Eddym06/MiguelOHM/Diseño Caja 3D/README.md

# Diseño Caja 3D

Carpeta para los diseños 3D de la caja.
