Eddym06/MiguelOHM/Diseño de carrito/README.md

# Diseño de carrito

Carpeta para los diseños del carrito.
