Eddym06/MiguelOHM/Codigo Carrito/README.md

# Código Carrito

Carpeta para el código del carrito.
