Eddym06/MiguelOHM/Documentación/DOC - CARRITO DOCUMENTO.docx

Especificación de requisitos de software

Proyecto: Sistema Carrito RC

Revisión 3

| | Octubre de 2026

De la plantilla de formato del documento © & Coloriuris http://www.qualitatis.org

# Ficha del documento

Fecha | Revisión | Autor | Verificado dep. calidad.
2026-10-09 | 1 | Simone Bariola
2026-10-23 | 2 | Simone Bariola
2026-10-29 | 3 | Simone Bariola

Documento validado por las partes en fecha:

Por el cliente | Por la empresa suministradora
Fdo. D./ Dña | Fdo. D./Dña

# Contenido

# 1 Introducción

## 1.1 Propósito

Este documento especifica los requisitos del Sistema Carrito RC, proyecto final de la asignatura Microcontroladores del Instituto Tecnológico de las Américas (ITLA), cuatrimestre 2026-C-3. Su objetivo es definir de forma verificable las funciones, las interfaces y las restricciones del sistema, y servir de base para el diseño mecánico, el diseño de la PCB, la programación del microcontrolador y las pruebas de aceptación.

Está dirigido al profesor de la asignatura, Carlos Antonio Pichardo, como cliente y evaluador del proyecto, y a los integrantes del equipo de desarrollo.

## 1.2 Alcance

El producto a desarrollar se denomina Sistema Carrito RC y comprende el Carrito y el Control giroscópico [TBR: inclusión del Control giroscópico en el producto]. El sistema permite conducir el Carrito de forma manual, desde el Control giroscópico o desde un dispositivo Bluetooth, y hacerlo navegar de forma autónoma entre coordenadas predefinidas mediante GPS, detectando los obstáculos y desviándose de ellos. Además, mantiene la velocidad de crucero en pendientes, informa al usuario del rumbo y del nivel de batería, e indica la velocidad mediante una tira LED.

No existe un documento de mayor nivel: esta SRS es la especificación de referencia del proyecto. [TBD: elementos fuera del alcance].

## 1.3 Personal involucrado

Nombre | Carlos Antonio Pichardo
Rol | Cliente y evaluador del proyecto (profesor de la asignatura Microcontroladores)
Categoría profesional
Responsabilidades
Información de contacto | cpichardo@itla.edu.do
Aprobación

Nombre | Simone Bariola
Rol
Categoría profesional
Responsabilidades | Documentación y diseño del Carrito
Información de contacto
Aprobación

Nombre | Eddy Manuel Piantini [TBR: nombre completo]
Rol
Categoría profesional
Responsabilidades
Información de contacto
Aprobación

Nombre | Edwin Joel Cabrera de Los Santos
Rol
Categoría profesional
Responsabilidades
Información de contacto
Aprobación

Nombre | José Nicolas Sánchez Zorrilla
Rol
Categoría profesional
Responsabilidades
Información de contacto
Aprobación

Nombre | Yisbel Diaz Brito
Rol
Categoría profesional
Responsabilidades
Información de contacto
Aprobación

Nombre | Josue Herrera
Rol
Categoría profesional
Responsabilidades
Información de contacto
Aprobación

## 1.4 Definiciones, acrónimos y abreviaturas

SRS: Especificación de requisitos de software (Software Requirements Specification).

RF: Requisito funcional. RNF: Requisito no funcional.

TBD: Por definir (To Be Defined). TBR: Por revisar (To Be Reviewed).

CAD: Diseño asistido por computadora.

PCB: Placa de circuito impreso.

GPS: Sistema de posicionamiento global.

LED: Diodo emisor de luz.

Modo giroscopio: conducción del Carrito mediante la inclinación del Control giroscópico.

Velocidad de crucero: velocidad de desplazamiento constante que el Carrito mantiene sin intervención del usuario.

Rumbo: orientación del Carrito respecto al norte, expresada en grados.

En este documento, la abreviatura RF designa siempre un requisito funcional; el término radiofrecuencia se escribe completo.

## 1.5 Referencias

Referencia | Titulo | Ruta | Fecha | Autor
[1] | IEEE Recommended Practice for Software Requirements Specifications (IEEE Std 830-1998) | — | 1998 | IEEE
[2] | FreeCAD | https://www.freecad.org | s. f. | FreeCAD
[3] | Términos de licencia de SOLIDWORKS Student Edition | [TBD: URL] | s. f. | Dassault Systèmes SolidWorks Corporation
[4] | Repositorio del proyecto MiguelOHM | https://github.com/Eddym06/MiguelOHM | 2026 | Equipo del proyecto

## 1.6 Resumen

La sección 2 describe el producto de forma general: su contexto, sus funciones, sus usuarios, sus restricciones y las suposiciones de las que depende. La sección 3 detalla los requisitos específicos (interfaces, requisitos funcionales y no funcionales) en forma numerada para su trazabilidad. La sección 4 contiene los apéndices.

# 2 Descripción general

## 2.1 Perspectiva del producto

El Sistema Carrito RC es un producto independiente: no forma parte de un sistema mayor ni sustituye a un sistema existente. Está compuesto por los siguientes elementos, diseñados por el equipo del proyecto [TBR: inclusión del Control giroscópico en el producto]:

- Carrito: vehículo terrestre a escala que opera en modo de conducción manual o en modo de navegación autónoma, siguiendo trayectorias entre coordenadas predefinidas.

- Control giroscópico: mando de mano con palancas, detección de inclinación, botón de modo y pantalla, desde el que el Usuario envía las órdenes de conducción y consulta la telemetría del Carrito.

El equipo del proyecto desarrolla el diseño mecánico del Carrito en FreeCAD y el diseño de la placa de circuito impreso (PCB) de su sistema electrónico. [TBD: resto del alcance del desarrollo].

Se seleccionó FreeCAD por ser un modelador CAD 3D paramétrico, libre y de código abierto, distribuido bajo la licencia GNU LGPL 2.1, que permite su uso sin costo en entornos académicos y comerciales (FreeCAD, s. f.). La alternativa considerada, SOLIDWORKS Student Edition, se licencia exclusivamente para uso educativo y no comercial, tiene una vigencia de 12 meses, identifica los archivos y planos generados como pertenecientes a la edición estudiantil y no garantiza que dichos archivos puedan abrirse en las versiones comerciales del software (Dassault Systèmes SolidWorks Corporation, s. f.). Estas condiciones limitarían una eventual comercialización del diseño del Carrito.

El sistema interactúa con los siguientes actores y elementos de su entorno:

- Usuario: opera el Control giroscópico para enviar las órdenes de conducción y supervisa el estado del Carrito en la pantalla integrada.

- Sistema de posicionamiento global (GPS): suministra las señales de posicionamiento que el Carrito utiliza para determinar su posición y desplazarse en modo autónomo. [TBR: fuente de la orientación del Carrito].

- Dispositivo Bluetooth: medio de mando complementario para el envío de órdenes al Carrito. [TBD: tipo de dispositivo, versión del protocolo y órdenes disponibles].

- Entorno de operación: espacio físico en el que circula el Carrito, incluidas las irregularidades de la superficie, las pendientes del terreno y los obstáculos presentes en la trayectoria.

Las interfaces del sistema son las siguientes:

- I-01 (Control giroscópico <-> Carrito): enlace de radiofrecuencia para la transmisión bidireccional de las órdenes de control y de la telemetría (nivel de carga de la batería y orientación). [TBD: banda de operación].

- I-02 (Dispositivo Bluetooth -> Carrito): enlace inalámbrico secundario para la recepción de órdenes de mando. [TBD: versión y órdenes].

- I-03 (Satélites GPS -> Carrito): recepción unidireccional de las señales de posicionamiento para la navegación autónoma.

- I-04 (Usuario <-> Control giroscópico): interfaz física y visual que comprende las palancas, la inclinación del control, el botón de modo y la lectura de datos en la pantalla. [TBD: funciones adicionales del botón de modo].

- I-05 (Entorno de operación -> Carrito): lectura del entorno físico mediante sensores embarcados para la detección de obstáculos y de la pendiente del terreno.

La interfaz I-01 es interna, ya que comunica los dos elementos del producto; las interfaces I-02 a I-05 gestionan el intercambio con entidades externas.

La Figura 2.1 presenta la frontera del sistema, sus elementos internos y su interacción con los actores externos descritos.

[TBD: insertar el diagrama de contexto]

Figura 2.1. Diagrama de contexto del Sistema Carrito RC.

## 2.2 Funcionalidad del producto

El Carrito proporciona las funciones que se resumen a continuación, agrupadas por área. El detalle de cada función, con sus condiciones y valores de desempeño, se especifica en la sección 3.

Modos de operación

- F-01. Operación en modo de conducción manual y en modo de navegación autónoma.

- F-02. Cambio entre el modo de conducción manual y el modo de navegación autónoma. [TBD: medio de selección del modo].

Conducción manual

- F-03. Desplazamiento hacia adelante y hacia atrás según las órdenes recibidas del Control giroscópico.

- F-04. Giro según las órdenes recibidas del Control giroscópico, incluido el tipo de giro seleccionado mediante sus palancas.

- F-05. Ejecución de las órdenes de conducción por inclinación (modo giroscopio) recibidas del Control giroscópico.

- F-06. Ejecución de las órdenes de mando recibidas del Dispositivo Bluetooth.

Navegación autónoma

- F-07. Desplazamiento autónomo entre coordenadas predefinidas.

- F-08. Desvío de la trayectoria ante un obstáculo detectado y retorno a la ruta preestablecida una vez superado el obstáculo.

Seguridad y control de velocidad

- F-09. Detección de obstáculos en la trayectoria y emisión de una alerta. [TBD: tipo de alerta].

- F-10. Mantenimiento de la velocidad de crucero en pendientes de subida y de bajada. [TBD: modos de operación en que aplica].

Supervisión

- F-11. Determinación de la orientación (rumbo) del Carrito y su envío al Control giroscópico.

- F-12. Medición del nivel de carga de la batería y su envío al Control giroscópico.

Protección

- F-13. Protección eléctrica de los circuitos del Carrito.

Señalización

- F-14. Indicación luminosa de la velocidad mediante una tira LED montada en el alerón trasero. La tira permanece apagada con el Carrito detenido; al acelerar, los LED se encienden desde el centro hacia los extremos en proporción a la velocidad, hasta encenderse todos a la velocidad máxima; al frenar, se apagan gradualmente desde los extremos hacia el centro hasta quedar apagada cuando el Carrito se detiene. [TBD: número de LED de la tira y velocidad que corresponde a la tira completa].

## 2.3 Características de los usuarios

Tipo de usuario
Formación
Habilidades
Actividades

Descripción de los usuarios del producto, incluyendo nivel educacional, experiencia y experiencia técnica.

## 2.4 Restricciones

El diseño y el desarrollo del sistema están sujetos a las siguientes restricciones:

- El diseño mecánico del Carrito se realiza en FreeCAD (véase la sección 2.1).

- El documento sigue el formato del estándar IEEE Std 830-1998.

- El proyecto se desarrolla dentro del cuatrimestre 2026-C-3, con un equipo de seis integrantes.

- [TBD: microcontrolador, lenguaje de programación y entorno de desarrollo; se definirán con la lista de componentes].

## 2.5 Suposiciones y dependencias

Los requisitos de este documento dependen de los siguientes factores:

- La navegación autónoma supone que el Carrito opera al aire libre, con recepción de la señal GPS.

- El mando por Bluetooth supone que el usuario dispone de un dispositivo compatible. [TBD: versión del protocolo].

- La precisión de la navegación autónoma depende de la precisión del módulo GPS seleccionado; si cambia el módulo, se revisará el requisito RF-07.

## 2.6 Evolución previsible del sistema

Identificación de futuras mejoras al sistema, que podrán analizarse e implementarse en un futuro.

# 3 Requisitos específicos

## 3.1 Requisitos comunes de los interfaces

Descripción detallada de todas las entradas y salidas del sistema de software.

### 3.1.1 Interfaces de usuario

Describir los requisitos del interfaz de usuario para el producto. Esto puede estar en la forma de descripciones del texto o pantallas del interfaz. Por ejemplo posiblemente el cliente ha especificado el estilo y los colores del producto. Describa exacto cómo el producto aparecerá a su usuario previsto.

### 3.1.2 Interfaces de hardware

Especificar las características lógicas para cada interfaz entre el producto y los componentes de hardware del sistema. Se incluirán características de configuración.

### 3.1.3 Interfaces de software

Indicar si hay que integrar el producto con otros productos de software.

Para cada producto de software debe especificarse lo siguiente:

- Descripción del producto software utilizado
- Propósito del interfaz
- Definición del interfaz: contiendo y formato

### 3.1.4 Interfaces de comunicación

Describir los requisitos del interfaces de comunicación si hay comunicaciones con otros sistemas y cuales son las protocolos de comunicación.

## 3.2 Requisitos funcionales

Los requisitos funcionales se numeran de RF-01 a RF-14 y cada uno se traza a la función de la sección 2.2 que lo origina. Los valores marcados [TBD] se definirán con la lista de componentes del Carrito.

### 3.2.1 RF-01. Modos de operación

Número de requisito | RF-01
Nombre de requisito | Modos de operación
Tipo | [x] Requisito | [ ] Restricción
Fuente del requisito | Función F-01 (sección 2.2)
Prioridad del requisito | [x] Alta/Esencial | [ ] Media/Deseado | [ ] Baja/ Opcional

El Carrito deberá operar en dos modos excluyentes: conducción manual y navegación autónoma.

### 3.2.2 RF-02. Cambio de modo

Número de requisito | RF-02
Nombre de requisito | Cambio de modo
Tipo | [x] Requisito | [ ] Restricción
Fuente del requisito | Función F-02 (sección 2.2)
Prioridad del requisito | [x] Alta/Esencial | [ ] Media/Deseado | [ ] Baja/ Opcional

El Carrito deberá cambiar de modo al recibir la orden de cambio. [TBD: medio de selección del modo].

### 3.2.3 RF-03. Avance y retroceso

Número de requisito | RF-03
Nombre de requisito | Avance y retroceso
Tipo | [x] Requisito | [ ] Restricción
Fuente del requisito | Función F-03 (sección 2.2)
Prioridad del requisito | [x] Alta/Esencial | [ ] Media/Deseado | [ ] Baja/ Opcional

El Carrito deberá avanzar y retroceder según las órdenes recibidas del Control giroscópico. [TBD: relación entre la posición de la palanca y la velocidad].

### 3.2.4 RF-04. Giro

Número de requisito | RF-04
Nombre de requisito | Giro
Tipo | [x] Requisito | [ ] Restricción
Fuente del requisito | Función F-04 (sección 2.2)
Prioridad del requisito | [x] Alta/Esencial | [ ] Media/Deseado | [ ] Baja/ Opcional

El Carrito deberá girar según las órdenes de las palancas del Control giroscópico. [TBD: tipos de giro].

### 3.2.5 RF-05. Conducción por inclinación

Número de requisito | RF-05
Nombre de requisito | Conducción por inclinación
Tipo | [x] Requisito | [ ] Restricción
Fuente del requisito | Función F-05 (sección 2.2)
Prioridad del requisito | [ ] Alta/Esencial | [x] Media/Deseado | [ ] Baja/ Opcional

El Carrito deberá ejecutar las órdenes derivadas de la inclinación del Control giroscópico. [TBD: ángulo máximo y zona muerta].

### 3.2.6 RF-06. Mando por Bluetooth

Número de requisito | RF-06
Nombre de requisito | Mando por Bluetooth
Tipo | [x] Requisito | [ ] Restricción
Fuente del requisito | Función F-06 (sección 2.2)
Prioridad del requisito | [ ] Alta/Esencial | [x] Media/Deseado | [ ] Baja/ Opcional

El Carrito deberá ejecutar las órdenes recibidas del Dispositivo Bluetooth. [TBD: órdenes disponibles y prioridad frente al Control giroscópico].

### 3.2.7 RF-07. Navegación entre coordenadas

Número de requisito | RF-07
Nombre de requisito | Navegación entre coordenadas
Tipo | [x] Requisito | [ ] Restricción
Fuente del requisito | Función F-07 (sección 2.2)
Prioridad del requisito | [x] Alta/Esencial | [ ] Media/Deseado | [ ] Baja/ Opcional

El Carrito deberá recorrer en orden una lista de coordenadas predefinidas y dar por alcanzado cada punto cuando se encuentre a menos de [TBD] m de él.

### 3.2.8 RF-08. Evasión de obstáculos

Número de requisito | RF-08
Nombre de requisito | Evasión de obstáculos
Tipo | [x] Requisito | [ ] Restricción
Fuente del requisito | Función F-08 (sección 2.2)
Prioridad del requisito | [x] Alta/Esencial | [ ] Media/Deseado | [ ] Baja/ Opcional

En modo de navegación autónoma, el Carrito deberá desviarse de un obstáculo detectado a menos de [TBD] cm y retomar la ruta preestablecida una vez superado.

### 3.2.9 RF-09. Alerta de obstáculo

Número de requisito | RF-09
Nombre de requisito | Alerta de obstáculo
Tipo | [x] Requisito | [ ] Restricción
Fuente del requisito | Función F-09 (sección 2.2)
Prioridad del requisito | [x] Alta/Esencial | [ ] Media/Deseado | [ ] Baja/ Opcional

El Carrito deberá detectar obstáculos situados a menos de [TBD] cm en su trayectoria y emitir una alerta. [TBD: tipo de alerta y modos en que aplica].

### 3.2.10 RF-10. Velocidad de crucero

Número de requisito | RF-10
Nombre de requisito | Velocidad de crucero
Tipo | [x] Requisito | [ ] Restricción
Fuente del requisito | Función F-10 (sección 2.2)
Prioridad del requisito | [ ] Alta/Esencial | [x] Media/Deseado | [ ] Baja/ Opcional

El Carrito deberá mantener la velocidad de crucero, con una desviación máxima de [TBD] %, en pendientes de subida y de bajada de hasta [TBD]°.

### 3.2.11 RF-11. Rumbo

Número de requisito | RF-11
Nombre de requisito | Rumbo
Tipo | [x] Requisito | [ ] Restricción
Fuente del requisito | Función F-11 (sección 2.2)
Prioridad del requisito | [x] Alta/Esencial | [ ] Media/Deseado | [ ] Baja/ Opcional

El Carrito deberá determinar su rumbo con una resolución de [TBD]° y enviarlo al Control giroscópico cada [TBD] s.

### 3.2.12 RF-12. Nivel de batería

Número de requisito | RF-12
Nombre de requisito | Nivel de batería
Tipo | [x] Requisito | [ ] Restricción
Fuente del requisito | Función F-12 (sección 2.2)
Prioridad del requisito | [ ] Alta/Esencial | [x] Media/Deseado | [ ] Baja/ Opcional

El Carrito deberá medir el nivel de carga de su batería y enviarlo al Control giroscópico cada [TBD] s.

### 3.2.13 RF-13. Protección eléctrica

Número de requisito | RF-13
Nombre de requisito | Protección eléctrica
Tipo | [x] Requisito | [ ] Restricción
Fuente del requisito | Función F-13 (sección 2.2)
Prioridad del requisito | [x] Alta/Esencial | [ ] Media/Deseado | [ ] Baja/ Opcional

El Carrito deberá proteger sus circuitos contra [TBD: tipos de falla; se definirán con la lista de componentes].

### 3.2.14 RF-14. Tira LED de velocidad

Número de requisito | RF-14
Nombre de requisito | Tira LED de velocidad
Tipo | [x] Requisito | [ ] Restricción
Fuente del requisito | Función F-14 (sección 2.2)
Prioridad del requisito | [ ] Alta/Esencial | [ ] Media/Deseado | [x] Baja/ Opcional

La tira LED del alerón trasero deberá indicar la velocidad del Carrito según lo descrito en la función F-14. [TBD: número de LED y velocidad correspondiente a la tira completa].

## 3.3 Requisitos no funcionales

### 3.3.1 Requisitos de rendimiento

Especificación de los requisitos relacionados con la carga que se espera tenga que soportar el sistema. Por ejemplo, el número de terminales, el número esperado de usuarios simultáneamente conectados, número de transacciones por segundo que deberá soportar el sistema, etc.

Todos estos requisitos deben ser mesurables. Por ejemplo, indicando “el 95% de las transacciones deben realizarse en menos de 1 segundo”, en lugar de “los operadores no deben esperar a que se complete la transacción”.

### 3.3.2 Seguridad

Especificación de elementos que protegerán al software de accesos, usos y sabotajes maliciosos, así como de modificaciones o destrucciones maliciosas o accidentales. Los requisitos pueden especificar:

- Empleo de técnicas criptográficas.
- Registro de ficheros con “logs” de actividad.
- Asignación de determinadas funcionalidades a determinados módulos.
- Restricciones de comunicación entre determinados módulos.
- Comprobaciones de integridad de información crítica.

### 3.3.3 Fiabilidad

Especificación de los factores de fiabilidad necesaria del sistema. Esto se expresa generalmente como el tiempo entre los incidentes permisibles, o el total de incidentes permisible.

### 3.3.4 Disponibilidad

Especificación de los factores de disponibilidad final exigidos al sistema. Normalmente expresados en % de tiempo en los que el software tiene que mostrar disponibilidad.

### 3.3.5 Mantenibilidad

El código fuente del Carrito y los archivos de diseño se mantienen en el repositorio del proyecto (carpetas «Codigo Carrito», «Diseño de carrito» y «Diseño Caja 3D»). El mantenimiento lo realiza el equipo de desarrollo, y cada cambio de este documento se registra en Documentación/CHANGELOG.md con su autor y su aprobación.

### 3.3.6 Portabilidad

Especificación de atributos que debe presentar el software para facilitar su traslado a otras plataformas u entornos. Pueden incluirse:

- Porcentaje de componentes dependientes del servidor.
- Porcentaje de código dependiente del servidor.
- Uso de un determinado lenguaje por su portabilidad.
- Uso de un determinado compilador o plataforma de desarrollo.
- Uso de un determinado sistema operativo.

## 3.4 Otros requisitos

Cualquier otro requisito que no encaje en ninguna de las secciones anteriores.

Por ejemplo:

Requisitos culturales y políticos

Requisitos Legales

# 4 Apéndices

Pueden contener todo tipo de información relevante para la SRS pero que, propiamente, no forme parte de la SRS.

Descripción de requisitos del sofware

Modelo de ingeniería [Nombre documento] 0.3 Pág. 3

Sistema Carrito RC Especificación de requisitos de software Rev. 3 Pág. 5

Sistema Carrito RC Especificación de requisitos de software Rev. 3 Pág. 4
