Eddym06/MiguelOHM/Diseño Caja 3D/2 caja Bariola.FCStd

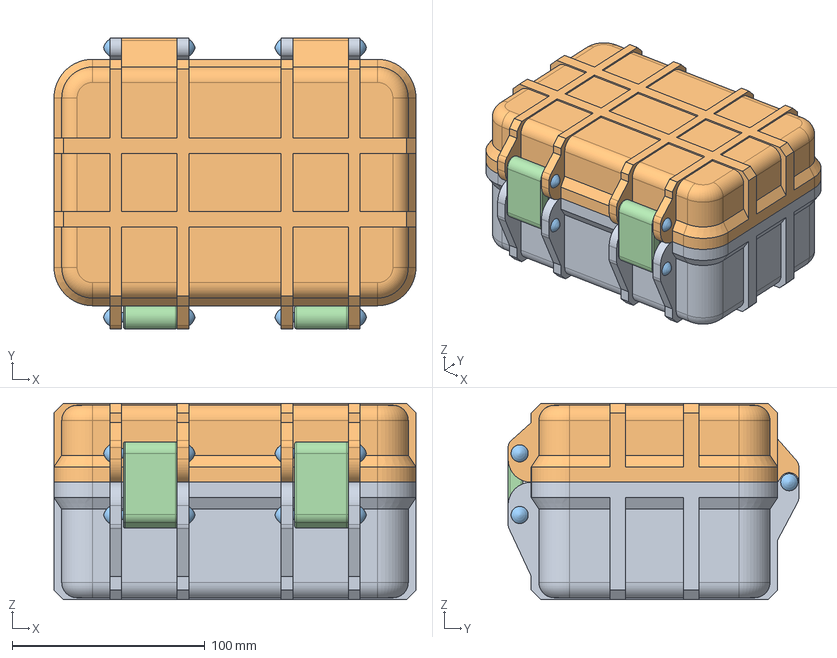
[picture p1: CAD file, 2026-10-16]
Diseño Caja 3D/2 caja Bariola.FCStd
188.0 x 151.0 x 102.0 mm
Cuerpo
cabeza
Barra x 6
Agarre x 2
