Eddym06/MiguelOHM/Diseño Caja 3D/1 caja Bariola.FCStd

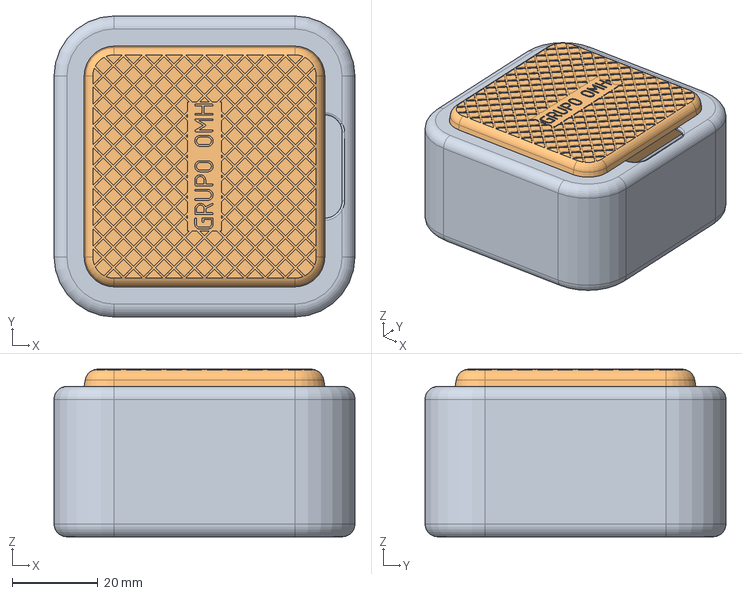
[picture p2: CAD file, 2026-10-16]
Diseño Caja 3D/1 caja Bariola.FCStd
70.0 x 70.0 x 39.0 mm
Cuerpo
Cuerpo001
