Eddym06/MiguelOHM/Documentación/CHANGELOG.md

| Fecha | Cambio | Propuesto por | Aprobado por |
|---|---|---|---|
| 2026-10-09 | Actualización del documento y conversión de .doc a .docx | Simone Bariola | Simone Bariola |
| 2026-10-23 | Se agrega F-14: tira LED de velocidad en el alerón trasero | Simone Bariola | Simone Bariola |
| 2026-10-29 | Revisión 3: se completan 1.1, 1.2, 1.4, 1.5, 1.6, 2.4, 2.5, 3.2 (RF-01 a RF-14) y 3.3.5; se corrigen 2.1 (estilo, párrafo duplicado, fragmento suelto, leyenda de la Figura 2.1) y las tablas de 1.3; se eliminan las instrucciones de la plantilla en las secciones completadas; se rellenan portada, encabezado y ficha del documento | Simone Bariola | Simone Bariola |
