Eddym06/MiguelOHM/Diseño de carrito/Tesla/Tesla.kicad_sch

## KiCad design Diseño de carrito/Tesla/Tesla.kicad_sch (2026-10-30)

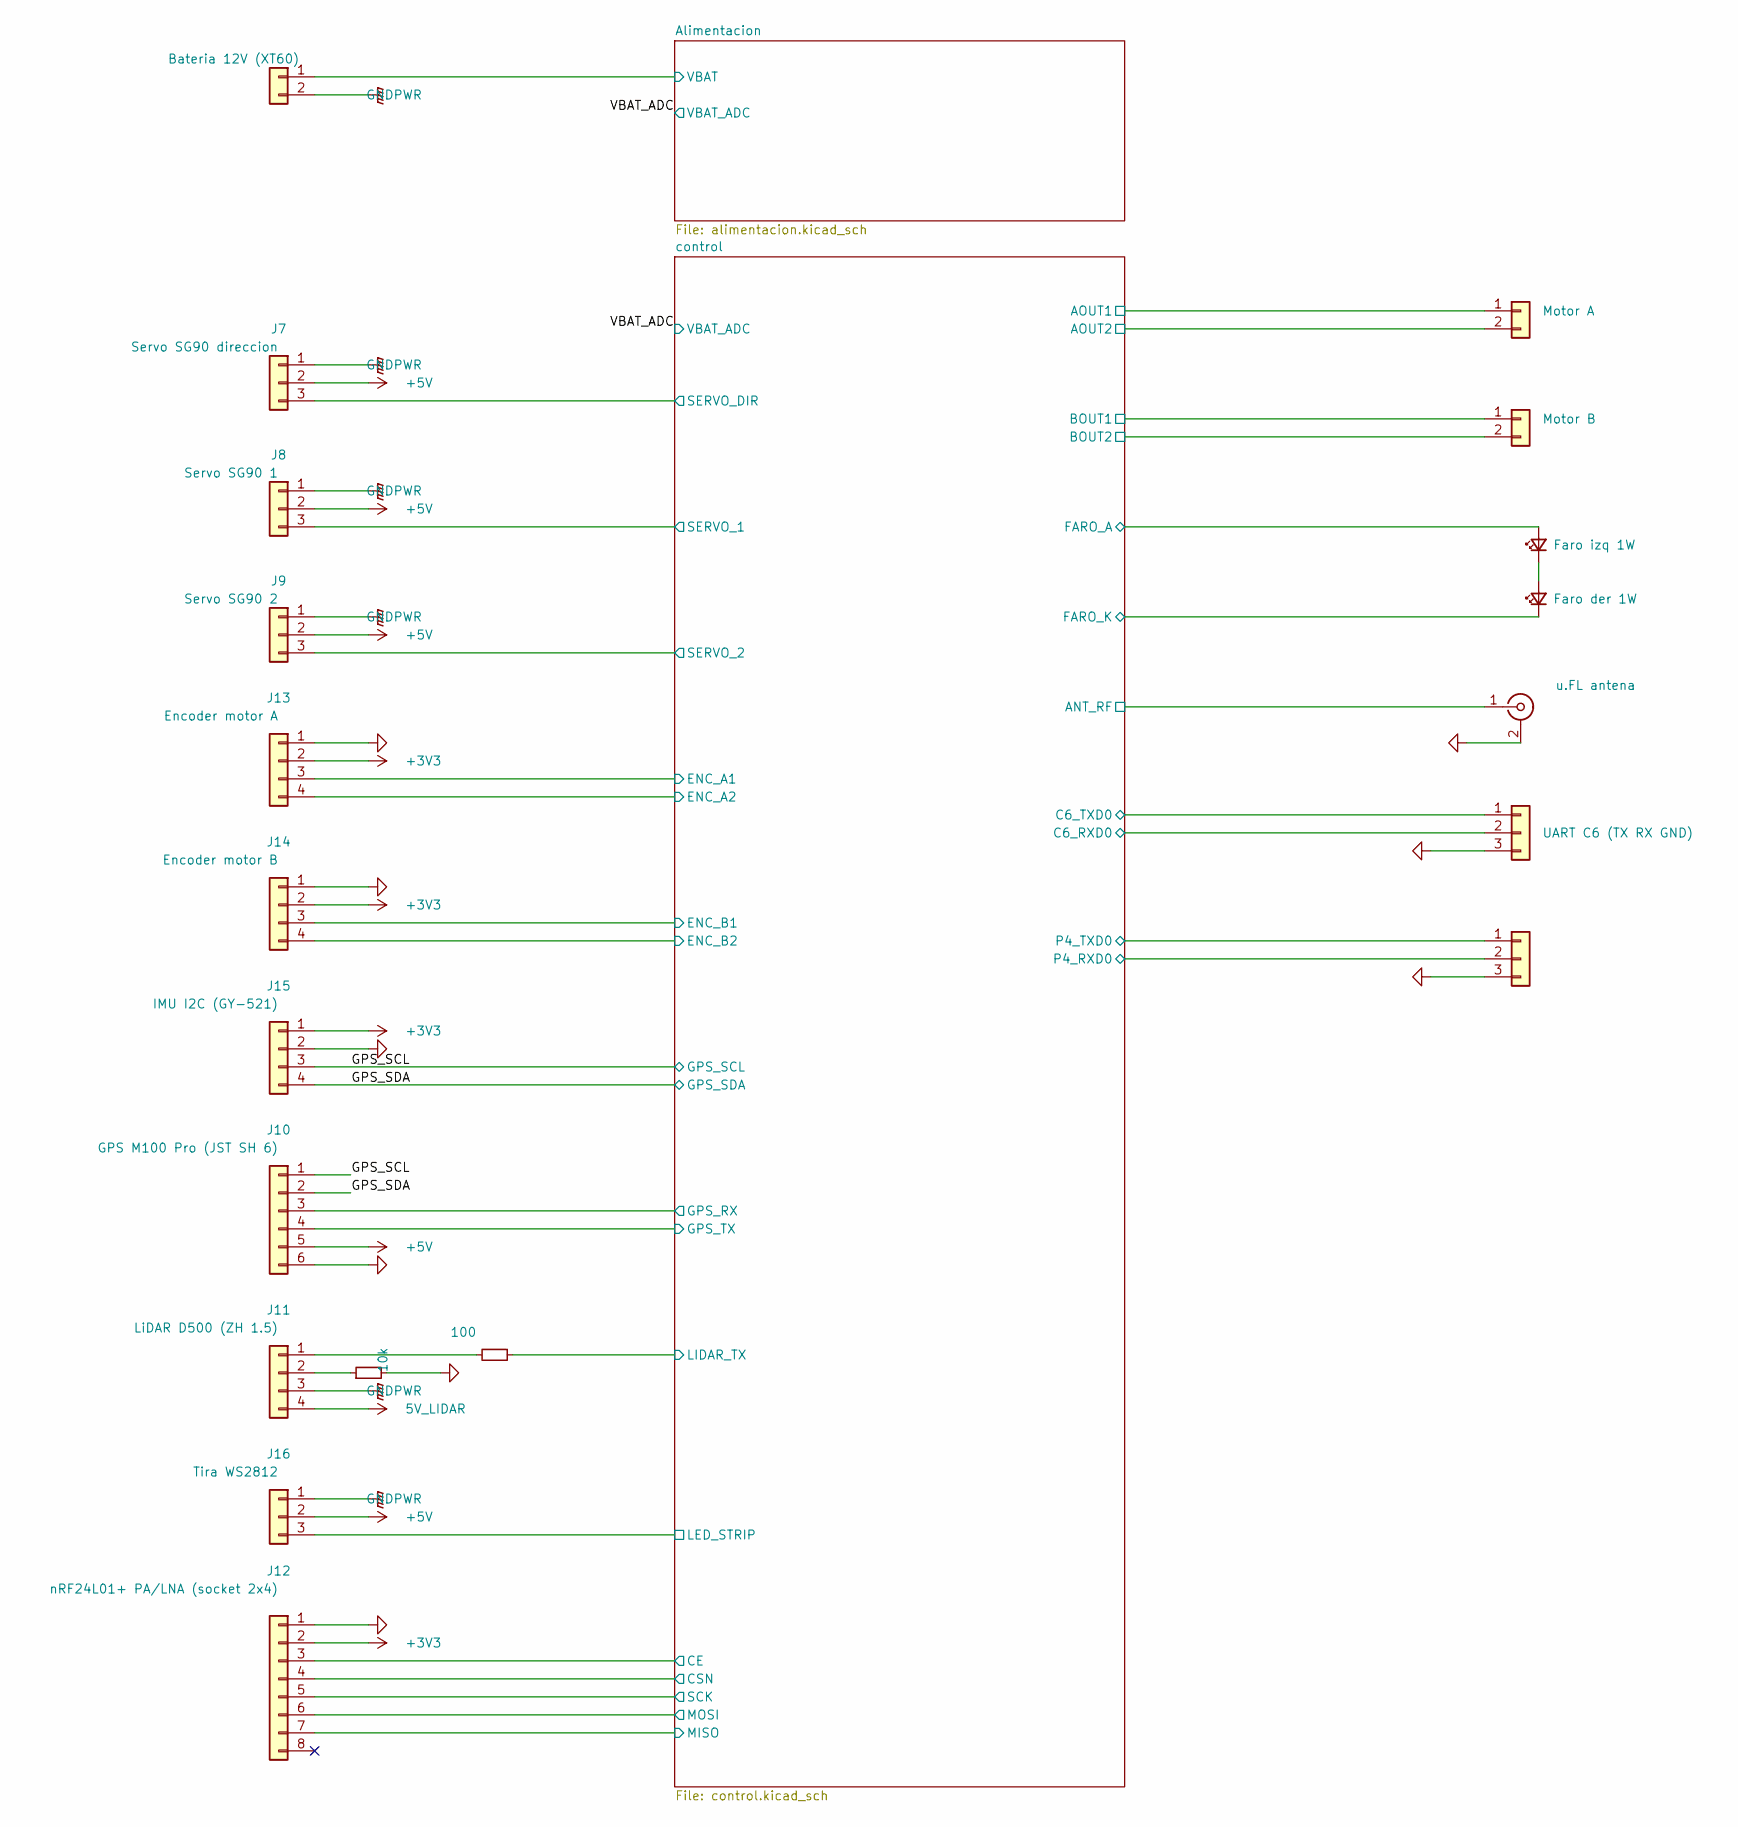
[picture p3: schematic Tesla.kicad_sch]

Parts:
D5: Faro izq 1W; LED_Cree-XP-G
D6: Faro der 1W; LED_Cree-XP-G
J1: u.FL antena; U.FL_Hirose_U.FL-R-SMT-1_Vertical
J2: UART C6 (TX RX GND); PinHeader_1x03_P2.54mm_Vertical
J3: UART0 P4 (RX TX GND); PinHeader_1x03_P2.54mm_Vertical
J4: Motor A; Molex_KK-254_AE-6410-02A_1x02_P2.54mm_Vertical
J5: Motor B; Molex_KK-254_AE-6410-02A_1x02_P2.54mm_Vertical
J6: Bateria 12V (XT60); AMASS_XT60-M_1x02_P7.20mm_Vertical
J7: Servo SG90 direccion; Molex_KK-254_AE-6410-03A_1x03_P2.54mm_Vertical
J8: Servo SG90 1; Molex_KK-254_AE-6410-03A_1x03_P2.54mm_Vertical
J9: Servo SG90 2; Molex_KK-254_AE-6410-03A_1x03_P2.54mm_Vertical
J10: GPS M100 Pro (JST SH 6); JST_SH_SM06B-SRSS-TB_1x06-1MP_P1.00mm_Horizontal
J11: LiDAR D500 (ZH 1.5); JST_ZH_B4B-ZR_1x04_P1.50mm_Vertical
J12: nRF24L01+ PA/LNA (socket 2x4); PinSocket_2x04_P2.54mm_Vertical
J13: Encoder motor A; Molex_KK-254_AE-6410-04A_1x04_P2.54mm_Vertical
J14: Encoder motor B; Molex_KK-254_AE-6410-04A_1x04_P2.54mm_Vertical
J15: IMU I2C (GY-521); PinHeader_1x04_P2.54mm_Vertical
J16: Tira WS2812; Molex_KK-254_AE-6410-03A_1x03_P2.54mm_Vertical
R23: 100; R_0402_1005Metric
R24: 10k; R_0402_1005Metric

Connections:
5V_LIDAR: J11.4
+3V3: J12.2, J13.2, J14.2, J15.1
+5V: J7.2, J8.2, J9.2, J10.5, J16.2
ANT_RF: J1.1 (In)
AOUT1: J4.1
AOUT2: J4.2
BOUT1: J5.1
BOUT2: J5.2
C6_RXD0: J2.2
C6_TXD0: J2.1
CE: J12.3
CSN: J12.4
ENC_A1: J13.3
ENC_A2: J13.4
ENC_B1: J14.3
ENC_B2: J14.4
FARO_A: D5.2 (A)
FARO_K: D6.1 (K)
GND: J1.2 (Ext), J2.3, J3.3, J10.6, J12.1, J13.1, J14.1, J15.2, R24.2
GNDPWR: J6.2, J7.1, J8.1, J9.1, J11.3, J16.1
GPS_RX: J10.3
GPS_SCL: J10.1, J15.3
GPS_SDA: J10.2, J15.4
GPS_TX: J10.4
LED_STRIP: J16.3
LIDAR_TX: R23.1
MISO: J12.7
MOSI: J12.6
unnamed: D5.1 (K), D6.2 (A)
unnamed: J11.1, R23.2
unnamed: J11.2, R24.1
P4_RXD0: J3.2
P4_TXD0: J3.1
SCK: J12.5
SERVO_1: J8.3
SERVO_2: J9.3
SERVO_DIR: J7.3
VBAT: J6.1
