Eddym06/MiguelOHM/Diseño de carrito/Tesla/alim_buck_3v3.kicad_sch

## KiCad design Diseño de carrito/Tesla/alim_buck_3v3.kicad_sch (2026-10-30)

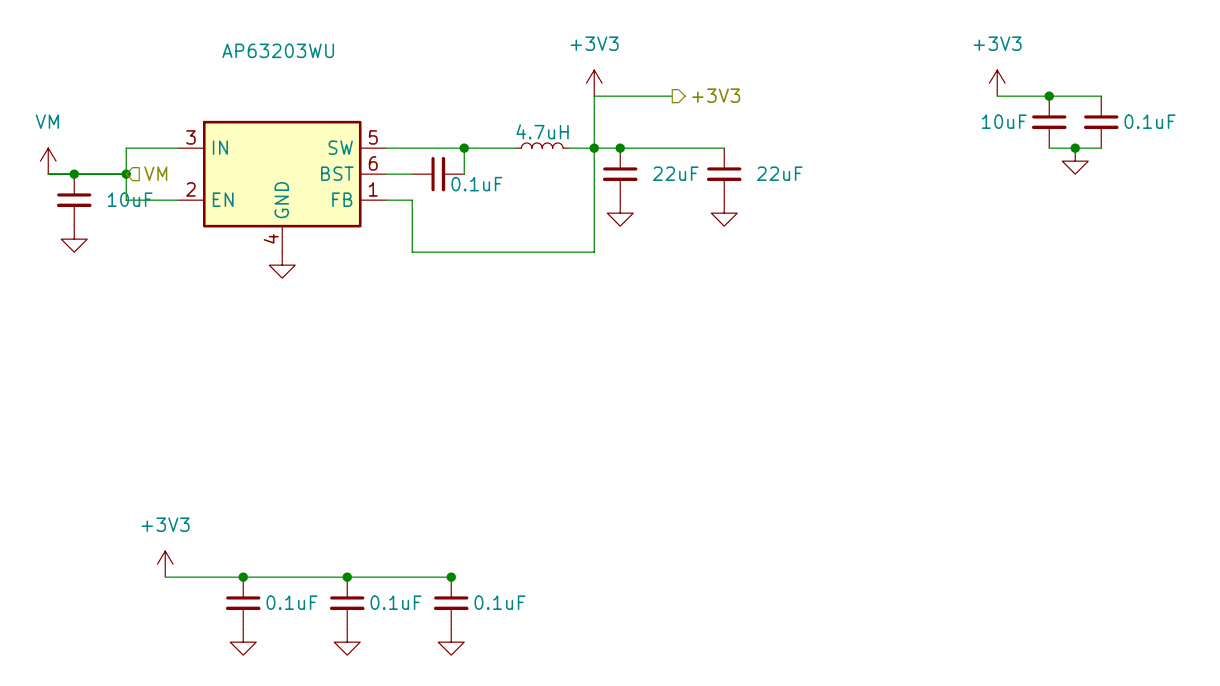
[picture p4: schematic alim_buck_3v3.kicad_sch]

Parts:
C45, C83: 10uF; C_0805_2012Metric
C46, C84, C91, C92, C93: 0.1uF; C_0402_1005Metric
C47, C48: 22uF; C_0805_2012Metric
L4: 4.7uH; L_0805_2012Metric
U6: AP63203WU; TSOT-23-6

Connections:
+3V3: C47.1, C48.1, C83.1, C84.1, C91.1, C92.1, C93.1, L4.2, U6.1 (FB)
GND: C45.2, C47.2, C48.2, C83.2, C84.2, C91.2, C92.2, C93.2, U6.4 (GND)
unnamed: C46.1, U6.6 (BST)
unnamed: C46.2, L4.1, U6.5 (SW)
VM: C45.1, U6.2 (EN), U6.3 (IN)
