Eddym06/MiguelOHM/Diseño de carrito/Tesla/alim_buck_5v.kicad_sch

## KiCad design Diseño de carrito/Tesla/alim_buck_5v.kicad_sch (2026-10-30)

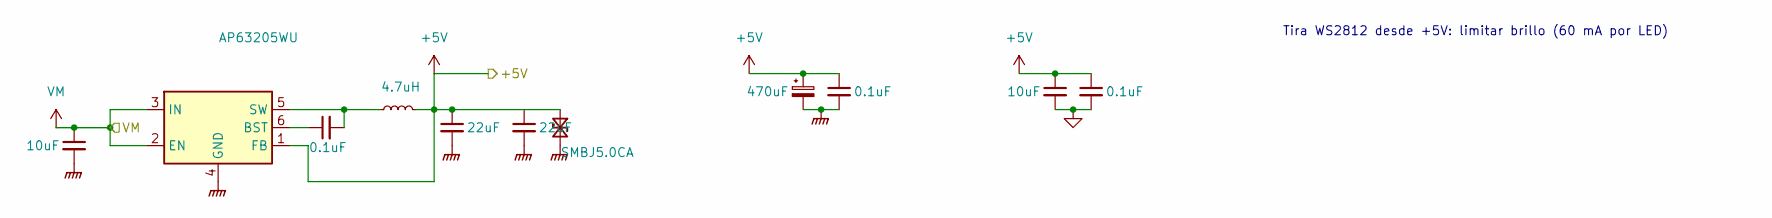
[picture p5: schematic alim_buck_5v.kicad_sch]

Parts:
C69, C79: 10uF; C_0805_2012Metric
C70, C78, C80: 0.1uF; C_0402_1005Metric
C71, C72: 22uF; C_0805_2012Metric
C77: 470uF; CP_Elec_6.3x5.4
D9: SMBJ5.0CA; D_SMB
L5: 4.7uH; L_Taiyo-Yuden_NR-50xx
U7: AP63205WU; TSOT-23-6

Connections:
+5V: C71.1, C72.1, C77.1, C78.1, C79.1, C80.1, D9.1 (A1), L5.2, U7.1 (FB)
GND: C79.2, C80.2
GNDPWR: C69.2, C71.2, C72.2, C77.2, C78.2, D9.2 (A2), U7.4 (GND)
unnamed: C70.1, U7.6 (BST)
unnamed: C70.2, L5.1, U7.5 (SW)
VM: C69.1, U7.2 (EN), U7.3 (IN)

Notes on the sheet:
Tira WS2812 desde +5V: limitar brillo (60 mA por LED)
