Eddym06/MiguelOHM/Diseño de carrito/Tesla/alim_buck_5v_lidar.kicad_sch

## KiCad design Diseño de carrito/Tesla/alim_buck_5v_lidar.kicad_sch (2026-10-30)

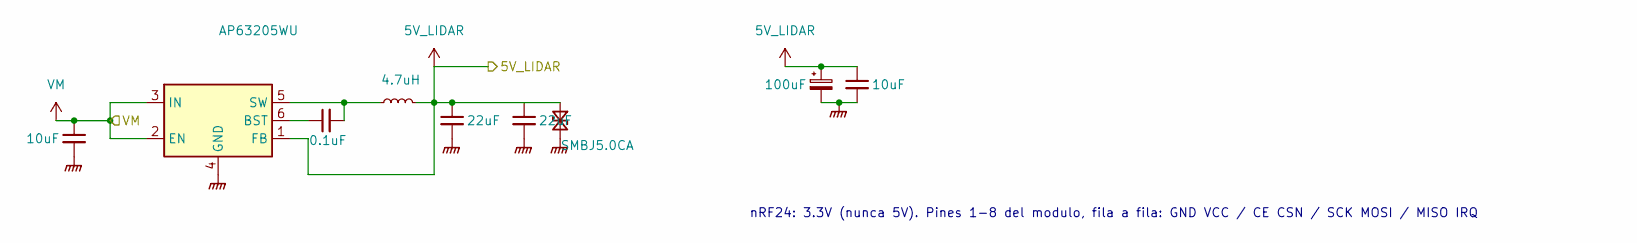
[picture p6: schematic alim_buck_5v_lidar.kicad_sch]

Parts:
C73, C82: 10uF; C_0805_2012Metric
C74: 0.1uF; C_0402_1005Metric
C75, C76: 22uF; C_0805_2012Metric
C81: 100uF; CP_Elec_6.3x5.4
D10: SMBJ5.0CA; D_SMB
L6: 4.7uH; L_Taiyo-Yuden_NR-50xx
U8: AP63205WU; TSOT-23-6

Connections:
5V_LIDAR: C75.1, C76.1, C81.1, C82.1, D10.1 (A1), L6.2, U8.1 (FB)
GNDPWR: C73.2, C75.2, C76.2, C81.2, C82.2, D10.2 (A2), U8.4 (GND)
unnamed: C74.1, U8.6 (BST)
unnamed: C74.2, L6.1, U8.5 (SW)
VM: C73.1, U8.2 (EN), U8.3 (IN)

Notes on the sheet:
nRF24: 3.3V (nunca 5V). Pines 1-8 del modulo, fila a fila: GND VCC / CE CSN / SCK MOSI / MISO IRQ
