Eddym06/MiguelOHM/Diseño de carrito/Tesla/alim_medicion.kicad_sch

## KiCad design Diseño de carrito/Tesla/alim_medicion.kicad_sch (2026-10-30)

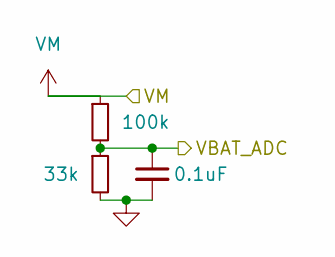
[picture p7: schematic alim_medicion.kicad_sch]

Parts:
C90: 0.1uF; C_0402_1005Metric
R28: 100k; R_0402_1005Metric
R29: 33k; R_0402_1005Metric

Connections:
GND: C90.2, R29.2
VBAT_ADC: C90.1, R28.2, R29.1
VM: R28.1
