Eddym06/MiguelOHM/Diseño de carrito/Tesla/alim_proteccion.kicad_sch

## KiCad design Diseño de carrito/Tesla/alim_proteccion.kicad_sch (2026-10-30)

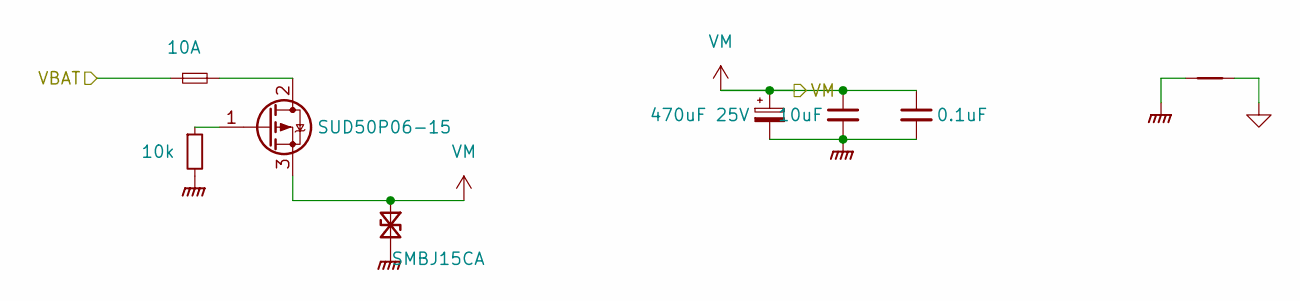
[picture p8: schematic alim_proteccion.kicad_sch]

Parts:
C85: 470uF 25V; CP_Elec_8x10
C86: 10uF; C_0805_2012Metric
C87: 0.1uF; C_0402_1005Metric
D8: SMBJ15CA; D_SMB
F1: 10A; Fuse_2920_7451Metric
NT1: NetTie_2; NetTie-2_SMD_Pad0.5mm
Q1: SUD50P06-15; TO-252-2
R27: 10k; R_0402_1005Metric

Connections:
GND: NT1.2
GNDPWR: C85.2, C86.2, C87.2, D8.2 (A2), NT1.1, R27.2
unnamed: F1.2, Q1.2 (D)
unnamed: Q1.1 (G), R27.1
VBAT: F1.1
VM: C85.1, C86.1, C87.1, D8.1 (A1), Q1.3 (S)
