Eddym06/MiguelOHM/Diseño de carrito/Tesla/cerebro_p4.kicad_sch

## KiCad design Diseño de carrito/Tesla/cerebro_p4.kicad_sch (2026-10-30)

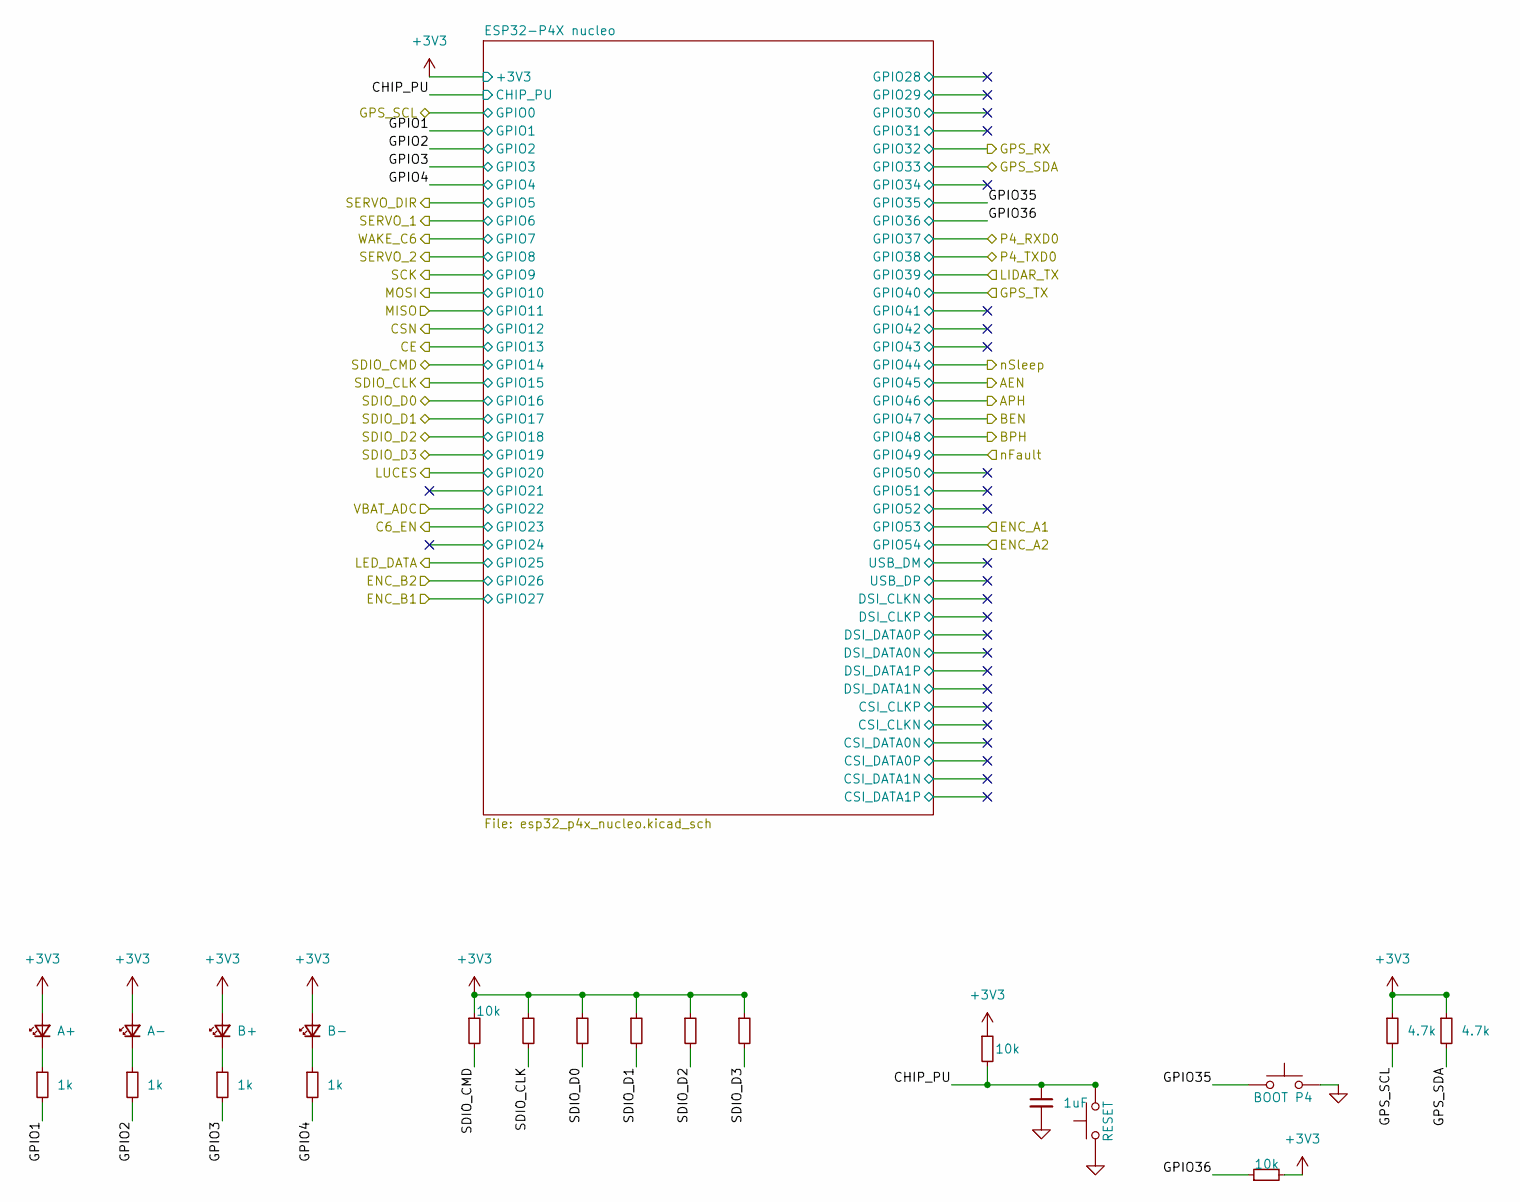
[picture p9: schematic cerebro_p4.kicad_sch]

Parts:
C16: 1uF; C_0402_1005Metric
D1: A+; LED_0603_1608Metric
D2: A-; LED_0603_1608Metric
D3: B+; LED_0603_1608Metric
D4: B-; LED_0603_1608Metric
R5, R6, R7, R8, R9, R10, R12, R13: 10k; R_0402_1005Metric
R17, R18, R19, R20: 1k; R_0402_1005Metric
R21, R22: 4.7k; R_0402_1005Metric
SW2: RESET; SW_SPST_TL3342
SW3: BOOT P4; SW_SPST_TL3342

Connections:
+3V3: D1.2 (A), D2.2 (A), D3.2 (A), D4.2 (A), R5.1, R6.1, R7.1, R8.1, R9.1, R10.1, R12.1, R13.2, R21.1, R22.1
CHIP_PU: C16.1, R12.2, SW2.2
GND: C16.2, SW2.1, SW3.1
GPIO1: R17.2
GPIO2: R18.2
GPIO3: R19.2
GPIO4: R20.2
GPIO35: SW3.2
GPIO36: R13.1
GPS_SCL: R21.2
GPS_SDA: R22.2
unnamed: D1.1 (K), R17.1
unnamed: D2.1 (K), R18.1
unnamed: D3.1 (K), R19.1
unnamed: D4.1 (K), R20.1
SDIO_CLK: R6.2
SDIO_CMD: R5.2
SDIO_D0: R7.2
SDIO_D1: R9.2
SDIO_D2: R10.2
SDIO_D3: R8.2
