Eddym06/MiguelOHM/Diseño de carrito/Tesla/esp32_p4x_nucleo.kicad_sch

## KiCad design Diseño de carrito/Tesla/esp32_p4x_nucleo.kicad_sch (2026-10-30)

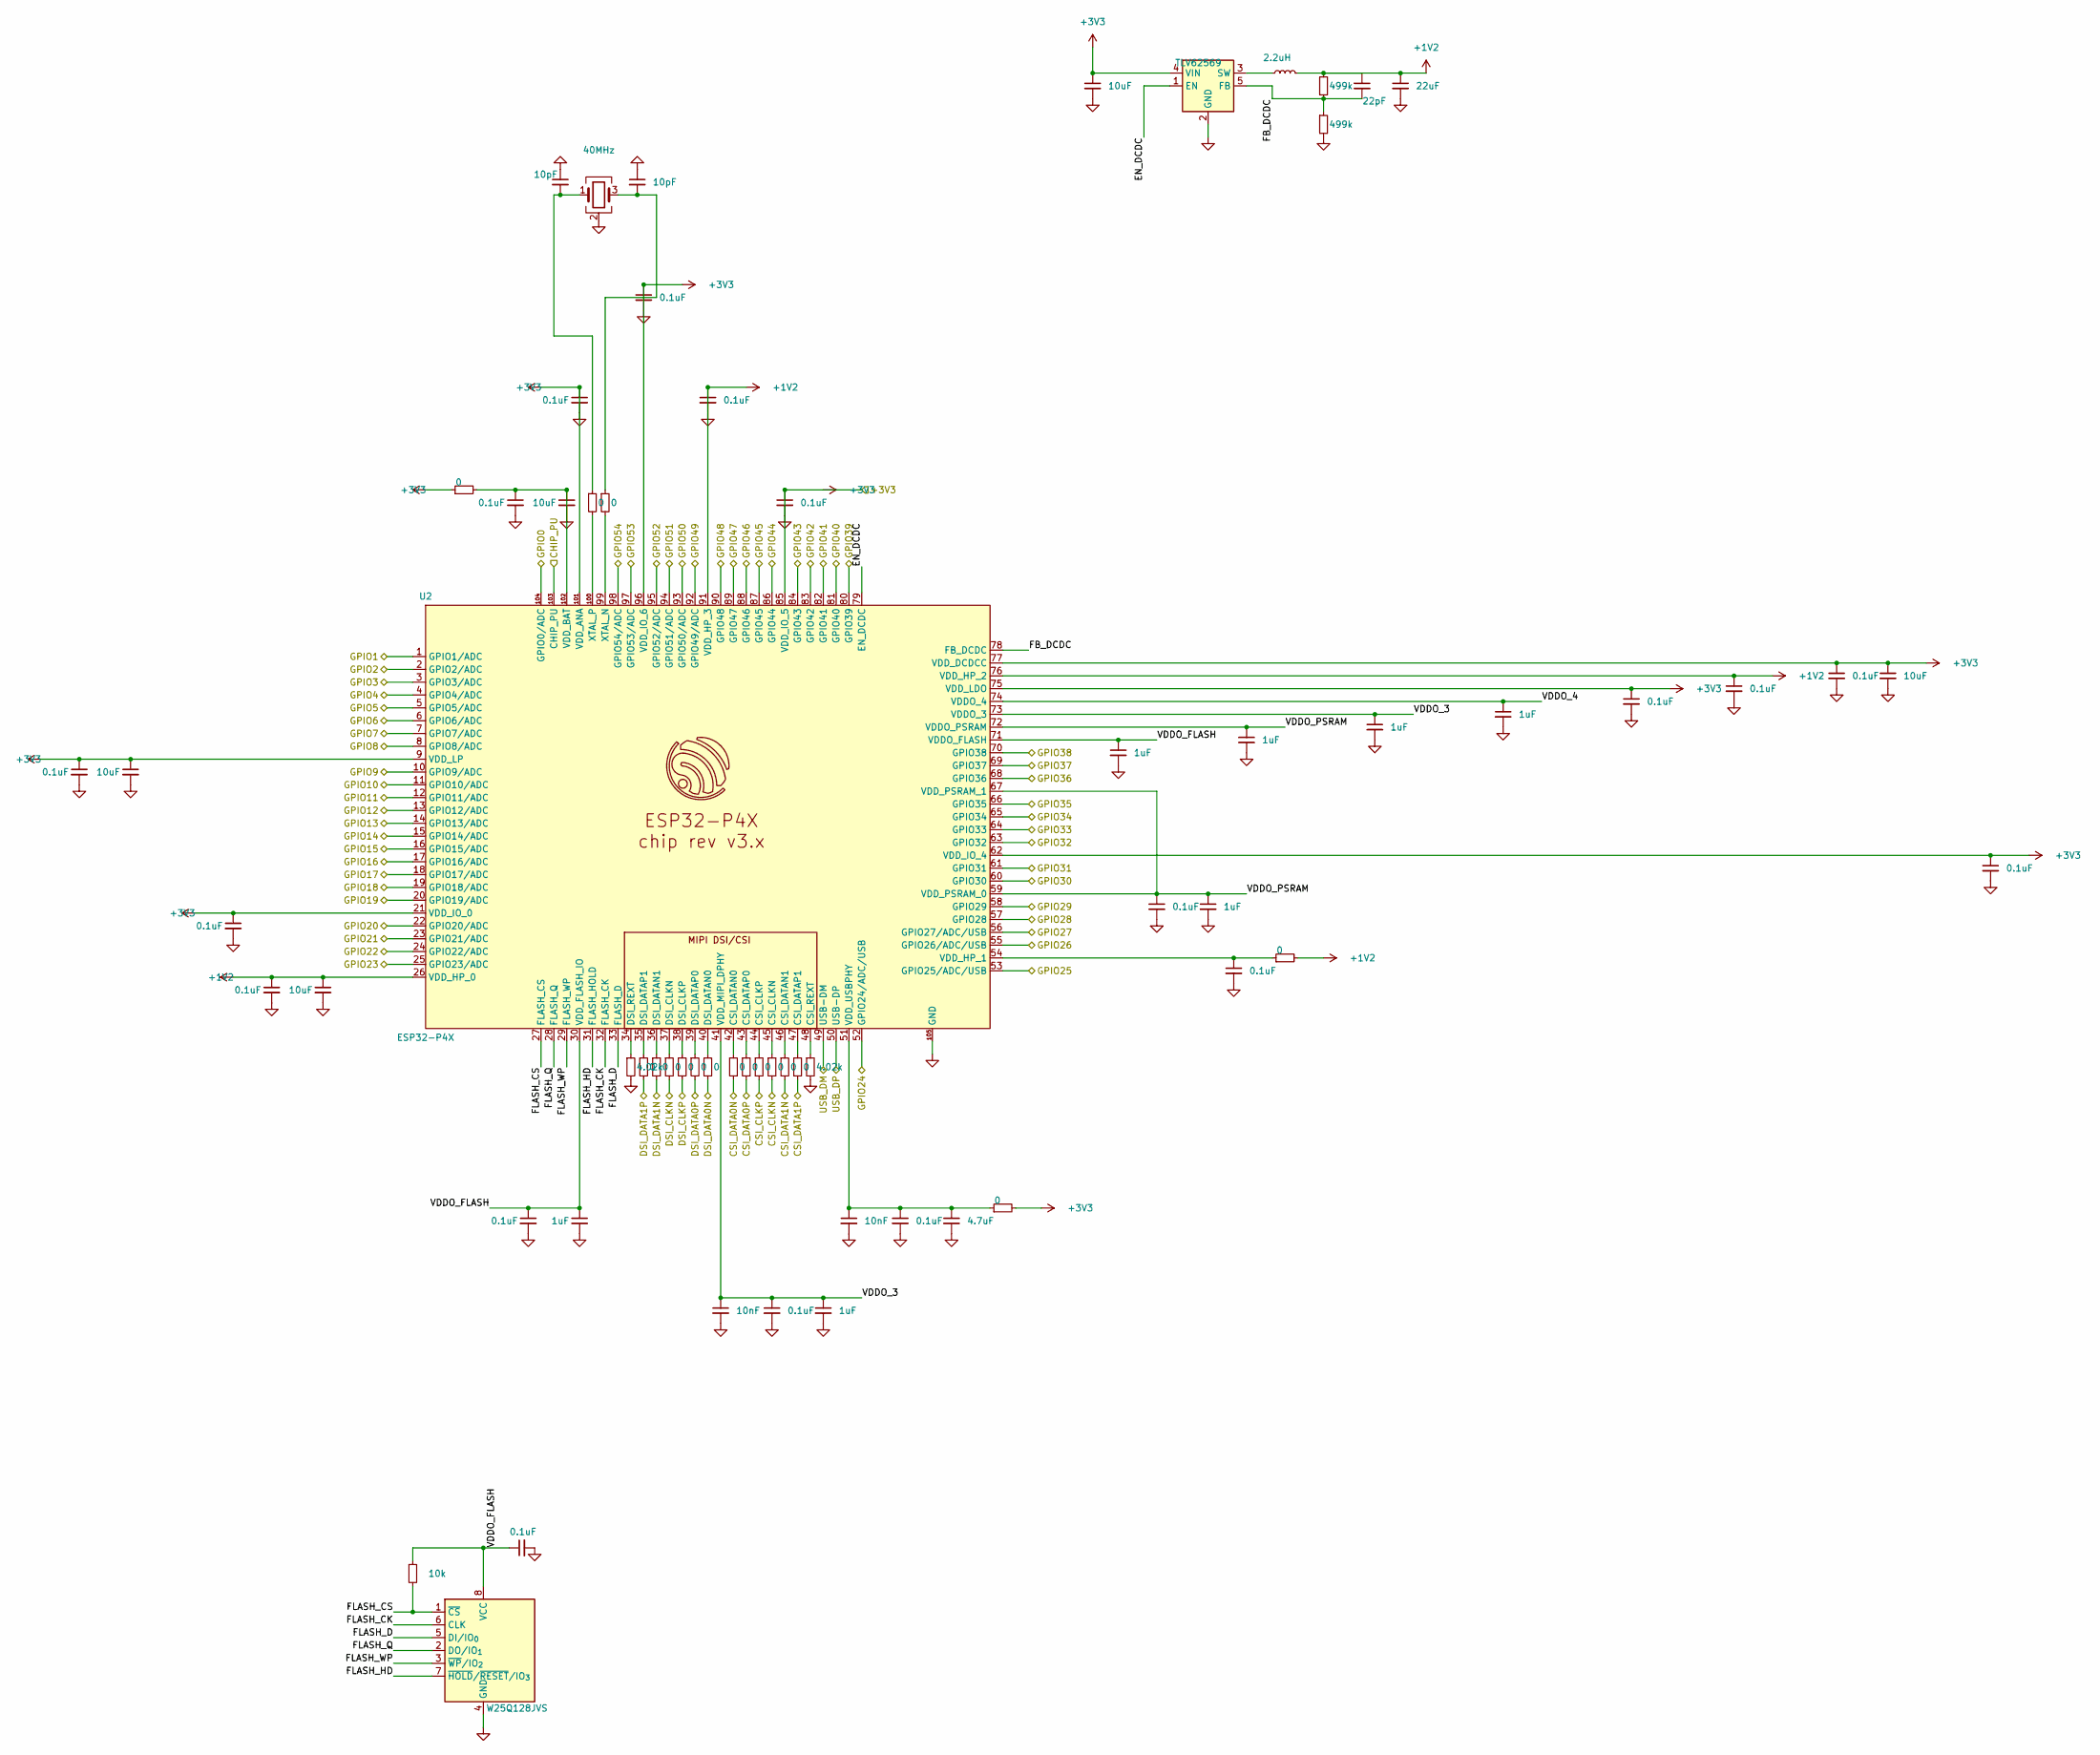
[picture p10: schematic esp32_p4x_nucleo.kicad_sch]

Parts:
C17, C18: 10pF; C_0402_1005Metric
C19: 22pF; C_0402_1005Metric
C54, C97, C98, C99, C100, C101, C106, C107, C108, C110, C111, C112, C115, C116, C118, C120, C122, C125: 0.1uF; C_0402_1005Metric
C96, C109, C114, C117, C127: 10uF; C_0805_2012Metric
C102, C103, C104, C105, C113, C119, C123: 1uF; C_0402_1005Metric
C121, C124: 10nF; C_0402_1005Metric
C126: 4.7uF; C_0805_2012Metric
C128: 22uF; C_0805_2012Metric
L3: 2.2uH; L_0805_2012Metric
R16: 10k; R_0402_1005Metric
R31, R44: 4.02k; R_0402_1005Metric
R32, R33, R34, R35, R36, R37, R38, R39, R40, R41, R42, R43, R45, R46, R47, R48, R49: 0; R_0402_1005Metric
R50, R51: 499k; R_0402_1005Metric
U2: ESP32-P4X; ESP32-P4
U4: TLV62569; SOT-23-5
U5: W25Q128JVS; SOIC-8_5.3x5.3mm_P1.27mm
Y2: 40MHz; Crystal_SMD_3225-4Pin_3.2x2.5mm

Connections:
+1V2: C17.1, C18.1, C19.1, C54.2, C96.1, C96.2, C97.1, C97.2, C98.1, C98.2, C99.1, C99.2, C100.1, C100.2, C101.1, C101.2, C102.2, C103.2, C104.2, C105.2, C106.1, C106.2, C107.1, C107.2, C108.1, C108.2, C109.1, C109.2, C110.1, C110.2, C111.2, C112.2, C113.2, C114.1, C114.2, C115.1, C115.2, C116.1, C116.2, C117.1, C117.2, C118.1, C118.2, C119.2, C120.2, C121.2, C122.2, C123.2, C124.2, C125.2, C126.2, C127.1, C127.2, C128.1, C128.2, L3.2, R31.2, R44.2, R45.1, R45.2, R46.2, R47.2, R50.1, R51.2, U2.9 (VDD_LP), U2.21 (VDD_IO_0), U2.26 (VDD_HP_0), U2.62 (VDD_IO_4), U2.75 (VDD_LDO), U2.76 (VDD_HP_2), U2.77 (VDD_DCDCC), U2.85 (VDD_IO_5), U2.91 (VDD_HP_3), U2.96 (VDD_IO_6), U2.101 (VDD_ANA), U2.102 (VDD_BAT), U2.105 (GND), U4.2 (GND), U4.4 (VIN), U5.4 (GND), Y2.2 (G), Y2.4 (G)
CHIP_PU: U2.103 (CHIP_PU)
CSI_CLKN: R41.2
CSI_CLKP: R40.2
CSI_DATA0N: R38.2
CSI_DATA0P: R39.2
CSI_DATA1N: R42.2
CSI_DATA1P: R43.2
DSI_CLKN: R34.2
DSI_CLKP: R35.2
DSI_DATA0N: R37.2
DSI_DATA0P: R36.2
DSI_DATA1N: R33.2
DSI_DATA1P: R32.2
EN_DCDC: U2.79 (EN_DCDC), U4.1 (EN)
FB_DCDC: C19.2, R50.2, R51.1, U2.78 (FB_DCDC), U4.5 (FB)
FLASH_CK: U2.32 (FLASH_CK), U5.6 (CLK)
FLASH_CS: R16.2, U2.27 (FLASH_CS), U5.1 (~CS)
FLASH_D: U2.33 (FLASH_D), U5.5 (DI/IO_{0})
FLASH_HD: U2.31 (FLASH_HOLD), U5.7 (~HOLD/~RESET/IO_{3})
FLASH_Q: U2.28 (FLASH_Q), U5.2 (DO/IO_{1})
FLASH_WP: U2.29 (FLASH_WP), U5.3 (~WP/IO_{2})
GPIO0: U2.104 (GPIO0/ADC)
GPIO1: U2.1 (GPIO1/ADC)
GPIO2: U2.2 (GPIO2/ADC)
GPIO3: U2.3 (GPIO3/ADC)
GPIO4: U2.4 (GPIO4/ADC)
GPIO5: U2.5 (GPIO5/ADC)
GPIO6: U2.6 (GPIO6/ADC)
GPIO7: U2.7 (GPIO7/ADC)
GPIO8: U2.8 (GPIO8/ADC)
GPIO9: U2.10 (GPIO9/ADC)
GPIO10: U2.11 (GPIO10/ADC)
GPIO11: U2.12 (GPIO11/ADC)
GPIO12: U2.13 (GPIO12/ADC)
GPIO13: U2.14 (GPIO13/ADC)
GPIO14: U2.15 (GPIO14/ADC)
GPIO15: U2.16 (GPIO15/ADC)
GPIO16: U2.17 (GPIO16/ADC)
GPIO17: U2.18 (GPIO17/ADC)
GPIO18: U2.19 (GPIO18/ADC)
GPIO19: U2.20 (GPIO19/ADC)
GPIO20: U2.22 (GPIO20/ADC)
GPIO21: U2.23 (GPIO21/ADC)
GPIO22: U2.24 (GPIO22/ADC)
GPIO23: U2.25 (GPIO23/ADC)
GPIO24: U2.52 (GPIO24/ADC/USB)
GPIO25: U2.53 (GPIO25/ADC/USB)
GPIO26: U2.55 (GPIO26/ADC/USB)
GPIO27: U2.56 (GPIO27/ADC/USB)
GPIO28: U2.57 (GPIO28)
GPIO29: U2.58 (GPIO29)
GPIO30: U2.60 (GPIO30)
GPIO31: U2.61 (GPIO31)
GPIO32: U2.63 (GPIO32)
GPIO33: U2.64 (GPIO33)
GPIO34: U2.65 (GPIO34)
GPIO35: U2.66 (GPIO35)
GPIO36: U2.68 (GPIO36)
GPIO37: U2.69 (GPIO37)
GPIO38: U2.70 (GPIO38)
GPIO39: U2.80 (GPIO39)
GPIO40: U2.81 (GPIO40)
GPIO41: U2.82 (GPIO41)
GPIO42: U2.83 (GPIO42)
GPIO43: U2.84 (GPIO43)
GPIO44: U2.86 (GPIO44)
GPIO45: U2.87 (GPIO45)
GPIO46: U2.88 (GPIO46)
GPIO47: U2.89 (GPIO47)
GPIO48: U2.90 (GPIO48)
GPIO49: U2.92 (GPIO49/ADC)
GPIO50: U2.93 (GPIO50/ADC)
GPIO51: U2.94 (GPIO51/ADC)
GPIO52: U2.95 (GPIO52/ADC)
GPIO53: U2.97 (GPIO53/ADC)
GPIO54: U2.98 (GPIO54/ADC)
unnamed: C17.2, R48.1, Y2.1
unnamed: C18.2, R49.1, Y2.3
unnamed: C111.1, R46.1, U2.54 (VDD_HP_1)
unnamed: C124.1, C125.1, C126.1, R47.1, U2.51 (VDD_USBPHY)
unnamed: L3.1, U4.3 (SW)
unnamed: R31.1, U2.34 (DSI_REXT)
unnamed: R32.1, U2.35 (DSI_DATAP1)
unnamed: R33.1, U2.36 (DSI_DATAN1)
unnamed: R34.1, U2.37 (DSI_CLKN)
unnamed: R35.1, U2.38 (DSI_CLKP)
unnamed: R36.1, U2.39 (DSI_DATAP0)
unnamed: R37.1, U2.40 (DSI_DATAN0)
unnamed: R38.1, U2.42 (CSI_DATAN0)
unnamed: R39.1, U2.43 (CSI_DATAP0)
unnamed: R40.1, U2.44 (CSI_CLKP)
unnamed: R41.1, U2.45 (CSI_CLKN)
unnamed: R42.1, U2.46 (CSI_DATAN1)
unnamed: R43.1, U2.47 (CSI_DATAP1)
unnamed: R44.1, U2.48 (CSI_REXT)
unnamed: R48.2, U2.100 (XTAL_P)
unnamed: R49.2, U2.99 (XTAL_N)
USB_DM: U2.49 (USB-DM)
USB_DP: U2.50 (USB-DP)
VDDO_3: C104.1, C121.1, C122.1, C123.1, U2.41 (VDD_MIPI_DPHY), U2.73 (VDDO_3)
VDDO_4: C105.1, U2.74 (VDDO_4)
VDDO_FLASH: C54.1, C102.1, C119.1, C120.1, R16.1, U2.30 (VDD_FLASH_IO), U2.71 (VDDO_FLASH), U5.8 (VCC)
VDDO_PSRAM: C103.1, C112.1, C113.1, U2.59 (VDD_PSRAM_0), U2.67 (VDD_PSRAM_1), U2.72 (VDDO_PSRAM)
