Eddym06/MiguelOHM/Diseño de carrito/Tesla/faros.kicad_sch

## KiCad design Diseño de carrito/Tesla/faros.kicad_sch (2026-10-30)

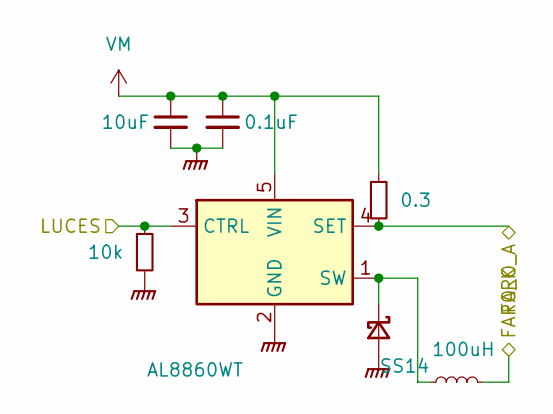
[picture p11: schematic faros.kicad_sch]

Parts:
C88: 10uF; C_0805_2012Metric
C89: 0.1uF; C_0402_1005Metric
D7: SS14; D_SMA
L7: 100uH; L_Bourns_SRN6045TA
R25: 0.3; R_0805_2012Metric
R26: 10k; R_0402_1005Metric
U9: AL8860WT; TSOT-23-5

Connections:
FARO_A: R25.2, U9.4 (SET)
FARO_K: L7.2
GNDPWR: C88.2, C89.2, D7.2 (A), R26.2, U9.2 (GND)
LUCES: R26.1, U9.3 (CTRL)
unnamed: D7.1 (K), L7.1, U9.1 (SW)
VM: C88.1, C89.1, R25.1, U9.5 (VIN)
