Eddym06/MiguelOHM/Diseño de carrito/Tesla/motores.kicad_sch

## KiCad design Diseño de carrito/Tesla/motores.kicad_sch (2026-10-30)

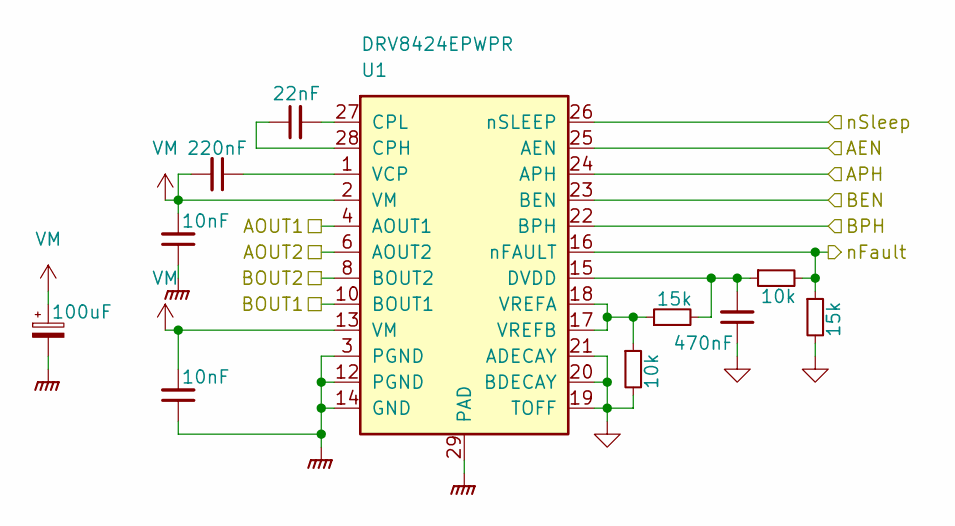
[picture p12: schematic motores.kicad_sch]

Parts:
C1: 22nF
C2: 220nF
C3, C4: 10nF
C5: 470nF; 10nF
C6: 100uF
R1, R3: 15k
R2, R4: 10k
U1: DRV8424EPWPR; SOP65P640X120-29N

Connections:
AEN: U1.25 (AEN)
AOUT1: U1.4 (AOUT1), U1.5 (AOUT1)
AOUT2: U1.6 (AOUT2), U1.7 (AOUT2)
APH: U1.24 (APH)
BEN: U1.23 (BEN)
BOUT1: U1.10 (BOUT1), U1.11 (BOUT1)
BOUT2: U1.8 (BOUT2), U1.9 (BOUT2)
BPH: U1.22 (BPH)
GND: C5.1, R1.2, R4.2, U1.19 (TOFF), U1.20 (BDECAY), U1.21 (ADECAY)
GNDPWR: C3.1, C4.1, C6.2, U1.3 (PGND), U1.12 (PGND), U1.14 (GND), U1.29 (PAD)
unnamed: C1.1, U1.28 (CPH)
unnamed: C1.2, U1.27 (CPL)
unnamed: C2.1, U1.1 (VCP)
unnamed: C5.2, R2.1, R3.2, U1.15 (DVDD)
unnamed: R3.1, R4.1, U1.17 (VREFB), U1.18 (VREFA)
VM: C2.2, C3.2, C4.2, C6.1, U1.2 (VM), U1.13 (VM)
nFault: R1.1, R2.2, U1.16 (nFAULT)
nSleep: U1.26 (nSLEEP)
