Eddym06/MiguelOHM/Diseño de carrito/Tesla/radio_c6.kicad_sch

## KiCad design Diseño de carrito/Tesla/radio_c6.kicad_sch (2026-10-30)

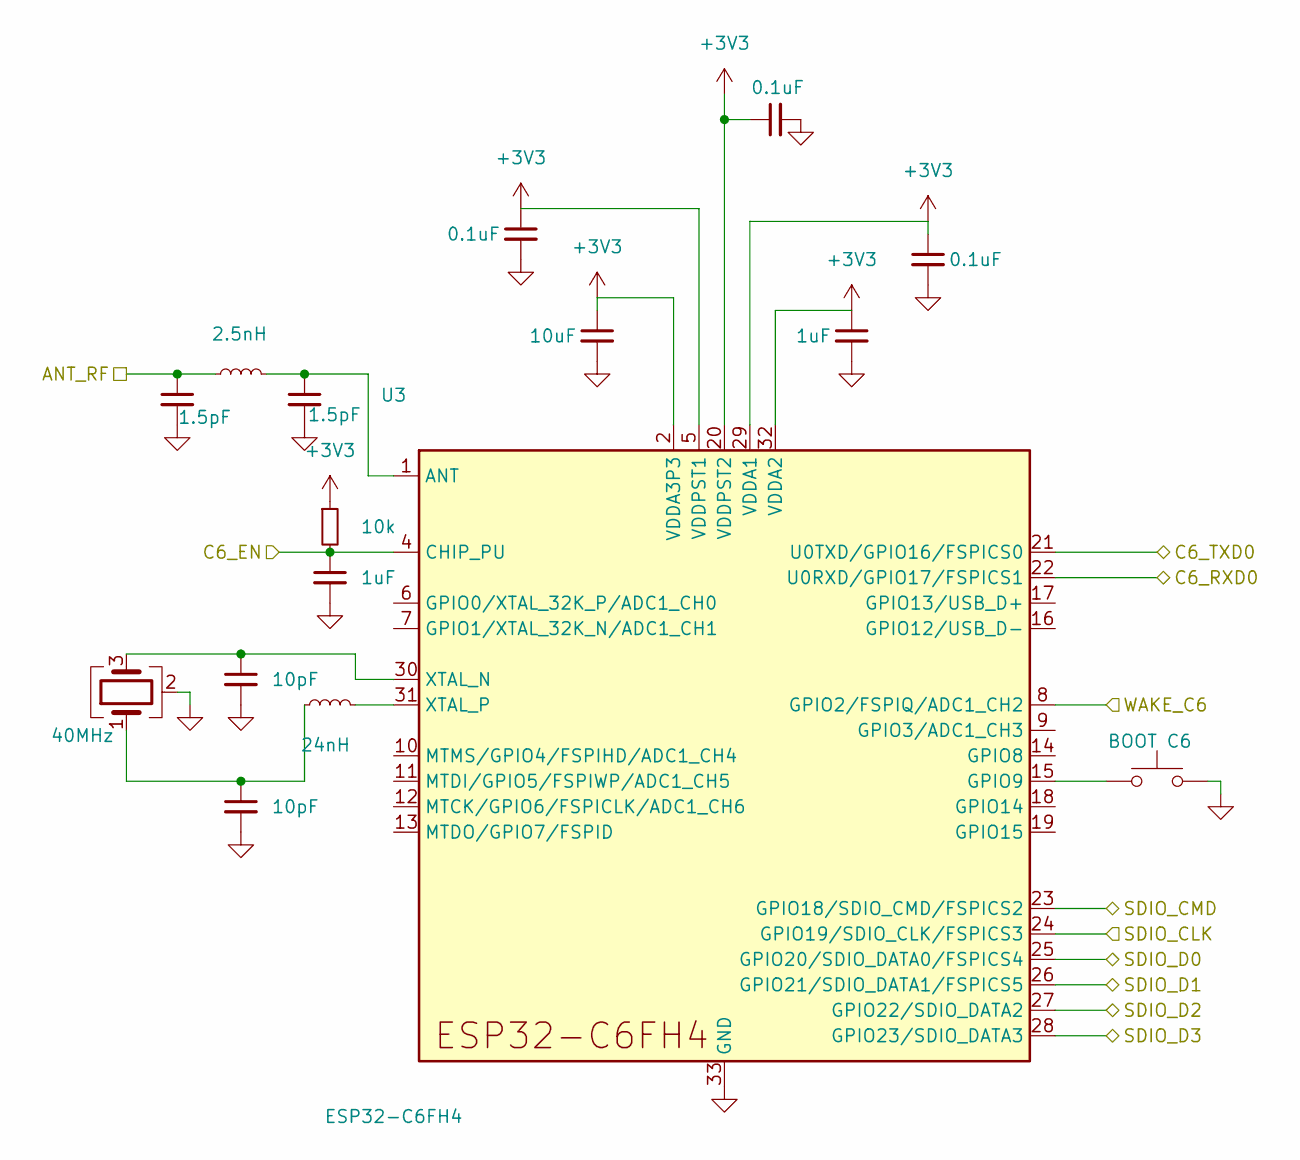
[picture p13: schematic radio_c6.kicad_sch]

Parts:
C11, C65: 1uF; C_0402_1005Metric
C12, C13: 1.5pF; C_0402_1005Metric
C14, C15: 10pF; C_0402_1005Metric
C63: 10uF; C_0805_2012Metric
C64, C66, C67: 0.1uF; C_0402_1005Metric
L1: 2.5nH; L_0805_2012Metric
L2: 24nH; L_0805_2012Metric
R11: 10k; R_0402_1005Metric
SW1: BOOT C6; SW_SPST_TL3342
U3: ESP32-C6FH4; ESP32-C6FH4_QFN32_Espressif
Y1: 40MHz; Crystal_SMD_3225-4Pin_3.2x2.5mm

Connections:
+3V3: C63.1, C64.1, C65.1, C66.1, C67.1, R11.1, U3.2 (VDDA3P3), U3.3 (VDDA3P3), U3.5 (VDDPST1), U3.20 (VDDPST2), U3.29 (VDDA1), U3.32 (VDDA2)
ANT_RF: C13.1, L1.1
C6_EN: C11.1, R11.2, U3.4 (CHIP_PU)
C6_RXD0: U3.22 (U0RXD/GPIO17/FSPICS1)
C6_TXD0: U3.21 (U0TXD/GPIO16/FSPICS0)
GND: C11.2, C12.2, C13.2, C14.2, C15.2, C63.2, C64.2, C65.2, C66.2, C67.2, SW1.2, U3.33 (GND), Y1.2 (G), Y1.4 (G)
unnamed: C12.1, L1.2, U3.1 (ANT)
unnamed: C14.1, U3.30 (XTAL_N), Y1.3
unnamed: C15.1, L2.1, Y1.1
unnamed: L2.2, U3.31 (XTAL_P)
unnamed: SW1.1, U3.15 (GPIO9)
SDIO_CLK: U3.24 (GPIO19/SDIO_CLK/FSPICS3)
SDIO_CMD: U3.23 (GPIO18/SDIO_CMD/FSPICS2)
SDIO_D0: U3.25 (GPIO20/SDIO_DATA0/FSPICS4)
SDIO_D1: U3.26 (GPIO21/SDIO_DATA1/FSPICS5)
SDIO_D2: U3.27 (GPIO22/SDIO_DATA2)
SDIO_D3: U3.28 (GPIO23/SDIO_DATA3)
WAKE_C6: U3.8 (GPIO2/FSPIQ/ADC1_CH2)
