Eddym06/MiguelOHM/Diseño de carrito/Tesla/tira_led.kicad_sch

## KiCad design Diseño de carrito/Tesla/tira_led.kicad_sch (2026-10-30)

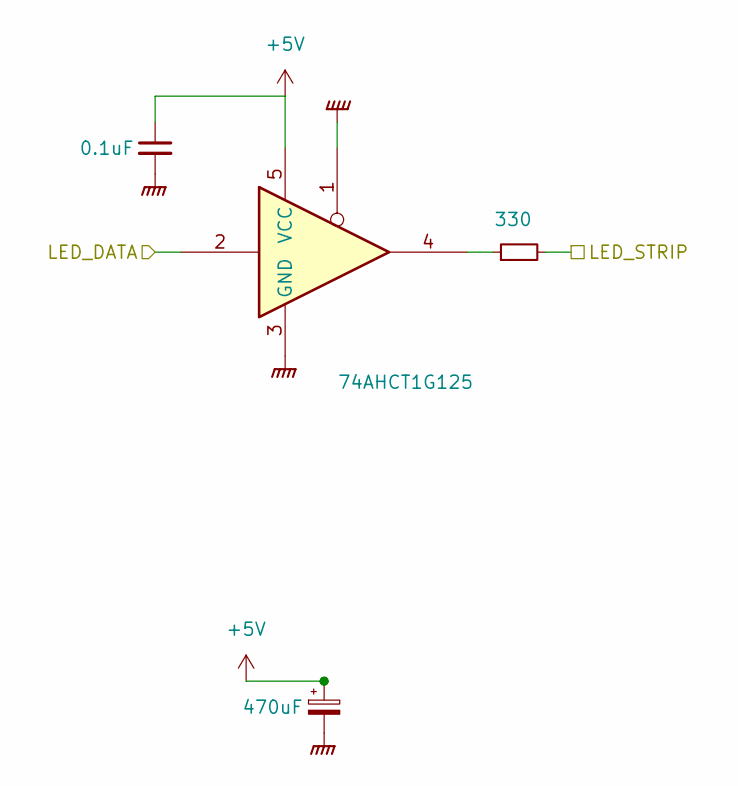
[picture p14: schematic tira_led.kicad_sch]

Parts:
C94: 0.1uF; C_0402_1005Metric
C95: 470uF; CP_Elec_6.3x5.4
R30: 330; R_0402_1005Metric
U10: 74AHCT1G125; SOT-353_SC-70-5

Connections:
+5V: C94.1, C95.1, U10.5 (VCC)
GNDPWR: C94.2, C95.2, U10.1, U10.3 (GND)
LED_DATA: U10.2
LED_STRIP: R30.2
unnamed: R30.1, U10.4
