Eddym06/MiguelOHM/(commit log)

2026-10-08 Se añadieron carpetas de organización
2026-10-08 Se añadieron README a las carpetas de organización
2026-10-23 Documentación: agrega F-14, tira LED de velocidad en el alerón
2026-10-29 Tesla: lista de materiales (XT60, faros AL8860, bucks 5V)
2026-10-30 Tesla: esquematico jerarquico completo (P4X rev v3.x, alimentacion por voltaje, control y modulos), librerias y lista de materiales
